wagiminator/ATtiny85-TinyCharger/hardware/TinyCharger_BOM.tsv

ID | Name | Designator | Footprint | Quantity | Manufacturer Part | Manufacturer | Supplier | Supplier Part
1 | 100n | C1,C3,C4 | 603 | 3 | CC0603KRX7R9BB104 | YAGEO | LCSC | C14663
2 | 10u | C2 | 603 | 1 | CL10A106MA8NRNC | SAMSUNG | LCSC | C96446
3 | HDR-M-2.54_1x2 | J1 | 210S-2X1/2.54 | 1 | X6511WR-02H-C30D60R1 | XKB Connectivity | LCSC | C2883840
4 | CHRG | LED1 | LED0603 | 1 | KT-0603R | KENTO | LCSC | C2286
5 | DONE | LED2 | LED0603 | 1 | 19-217/GHC-YR1S2/3T | EVERLIGHT | LCSC | C72043
6 | OLED 0.91 | OLED | I2C OLED 0.91 | 1 | SSD1306 I2C OLED
7 | PH-2AW RHOS | P1 | CONN-TH_2P-P2.00_PH-2AW | 1 | PH-2AW RHOS | BOOMELE | LCSC | C16965
8 | AO3400A | Q1,Q2 | SOT-23-3_L2.9-W1.6-P1.90-LS2.8-BR | 2 | AO3400A | AOS | LCSC | C20917
9 | 10k | R1,R3,R4 | 603 | 3 | 0603WAF1002T5E | UniOhm | LCSC | C25804
10 | R008 | R2 | 2512 | 1 | LCSR2512FR008Q9L | Resistor.Today | LCSC | C520396
11 | 1k | R5,R6,R10,R11 | 603 | 4 | 0603WAF1001T5E | UniOhm | LCSC | C21190
12 | 12k | R7 | 603 | 1 | 0603WAF1202T5E | UniOhm | LCSC | C22790
13 | 1k8 | R9 | 603 | 1 | 0603WAF1801T5E | UniOhm | LCSC | C4177
14 | 5k1 | R8,R12,R13 | 603 | 3 | 0603WAF5101T5E | UniOhm | LCSC | C23186
15 | RESET | SW1 | SW-SMD_TS24CA | 1 | TS24CA | SHOU HAN | LCSC | C393942
16 | SET | SW2 | SW-SMD_TS24CA | 1 | TS24CA | SHOU HAN | LCSC | C393942
17 | ATtiny85 | U1 | SOIC-8_208MIL | 1 | ATTINY85-20SU | MICROCHIP | LCSC | C89852
18 | INA219 | U2 | SOT-23-8_L3.0-W1.7-P0.65-LS2.8-BL | 1 | INA219AIDCNR | TI | LCSC | C87469
19 | TP4056 | U3 | SOP-8_EP_150MIL | 1 | TP4056-42-ESOP8 | TOPPOWER | LCSC | C16581
20 | USB PWR | USB1 | USB PWR CONNECTOR | 1 | KH-MICRO-SMT.J-2P | Shenzhen Kinghelm Elec | LCSC | C2688799
21 | USB-TYPE-C-6PIN | USB2 | USB-C-SMD-6P | 1 | TYPE-C-31-M-17 | Korean Hroparts Elec | LCSC | C283540
