wagiminator/ATtiny85-TinyCharger/hardware/TinyCharger_schematic.pdf

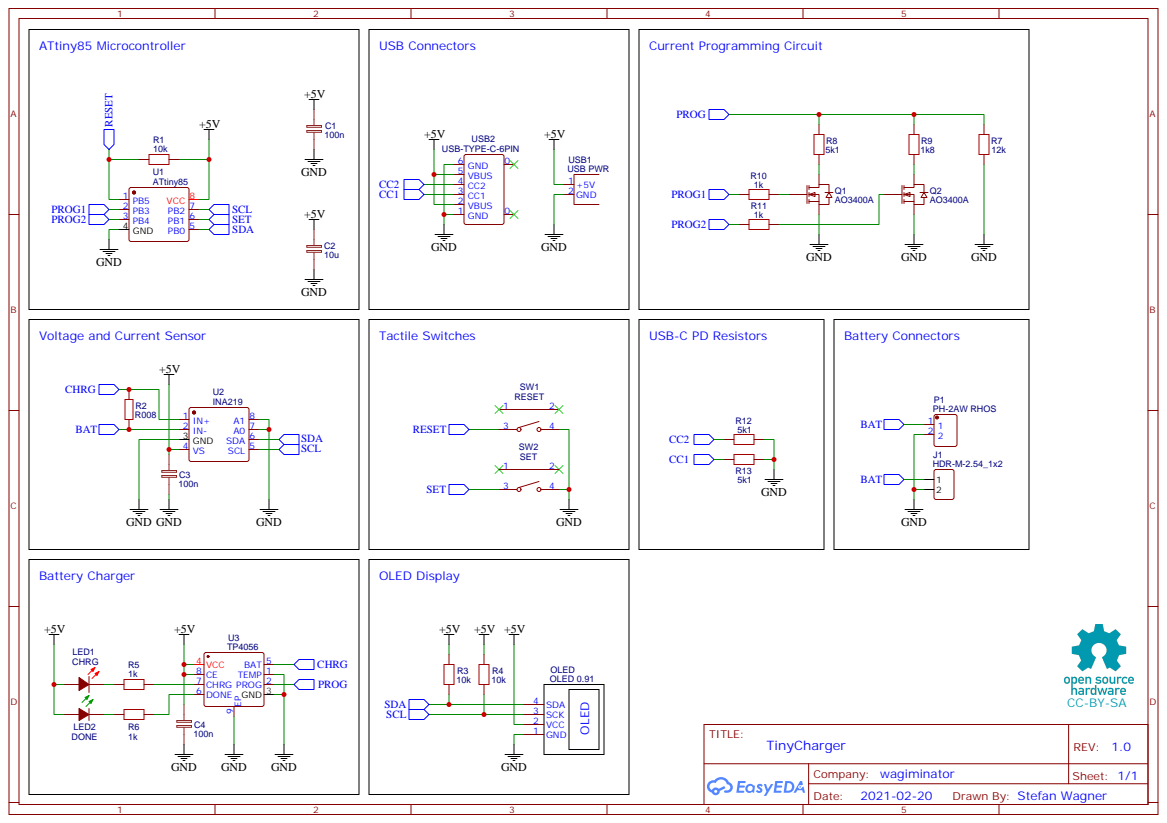
[picture p6: page 1]

Drawn By: Stefan Wagner
