wagiminator/ATtiny85-TinyCharger/(threads)

Thread 1 (2024-05-08):

When the TP4056 charged at 1000mAh?

LamDVT, 2024-05-08:
Hi wagiminator,

This is a very good project I have come across for working with TP4056.

I have checked the schematic and noticed that there are 3 resistors (12k, 5k1, and 1k8) for controlling the current output. If I want to charge at 1000mAh, I should use a 1k2 resistor, but I cannot find it in your project.

Could you please explain to me how it can charge at 1000mAh?

Thanks.

LamDVT, 2024-05-08:
I apologize for the confusion. After reviewing the source code, I discovered that setting all the prog pins to high enables charging at 1000mAh.

Closed 2024-05-08.
