wagiminator/ATtiny85-TinyCharger/(commit log)

2021-03-25 Easier hand soldering
2022-09-10 Update BOM
    [TinyCharger_BOM.tsv]
